FelipeRojasArr/Curiosity_SPARC/README.md

# Curiosity_SPARC
Documentación proyecto semestre i: SPARC
