FelipeRojasArr/Curiosity_SPARC/DocumentacionFinal/Análisis Mecánico SPARC Project.pdf

### Análisis Mecánico SPARC Project

Torque
De acuerdo a las especificaciones del motor a pasos NEMA 17 utilizado en el proyecto Sparc, éste proporciona un torque máximo de 3.2 Kg.cm, que de acuerdo al SI equivalen a .3138 N.m.
Al medir la tensión aplicada a la banda alrededor del eje del motor a pasos utilizando un dinamómetro didáctico, la perilla indica aproximadamente 0.4 N de tensión en ésta, el cual si lo multiplicamos por el radio de la polea alrededor del eje obtenemos el torque aplicado en éste último. En otras palabras:

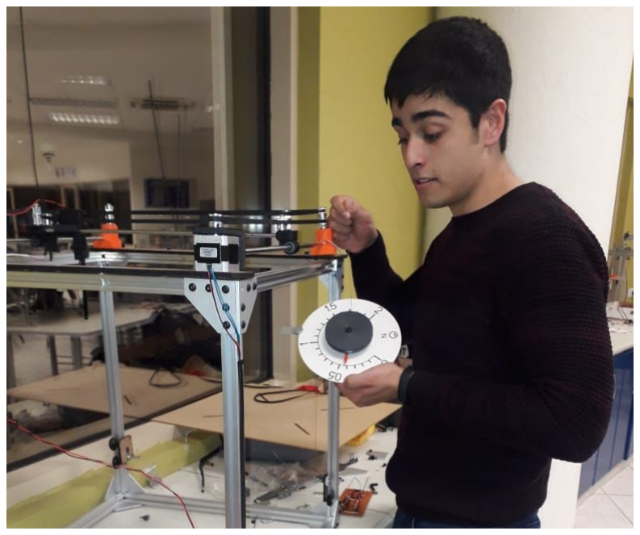
[picture p1: figure]

Imagen 1. Medición de tensión

Torque aplicado = (Fuerza)(distancia) = (0.4 N) (0. 0061 m) = .0024 N.m

La distancia se obtuvo dividiendo entre dos el diámetro externo de la polea gt2 que recibe la tensión. El torque real aplicado al sistema es entonces

.3138 N.m - .0024 N.m = .3114 N.m

Es posible inferir que el motor no se encuentra ni siquiera cerca de ser forzado o sobreexigido.

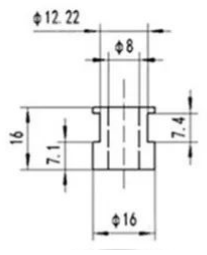
[picture p2: figure]
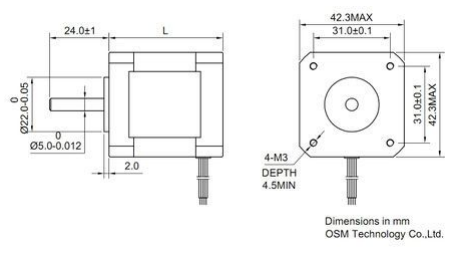
[picture p3: figure]

Imagen 2. Dimensiones de polea. | Imagen 3. Dimensiones de motor a pasos.

Factor de seguridad

La tensión de la banda calculada previamente afecta directamente al eje del motor a pasos en cuanto a Torsión y Flexión se refiere. Ambos aspectos se consideran en los teoremas de fatiga necesarios en el análisis de pruebas en diversos productos de la industria con la finalidad de aproximar la durabilidad de éstos últimos.

El siguiente análisis se basa en el teorema Mod-Goodman, que, basado serie cálculos y consideraciones que se explican con detalle a continuación, nos indica que sí el factor final n es menor a 1 nuestro sistema no es capaz de lograr 1 millón de ciclos en ejecución, mientras que siendo igual o mayor o 1 lo hace. El siguiente proceso denomina al eje del motor como fabricado en Latón.

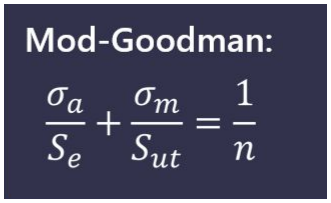
[picture p4: figure]

Imagen 4. Teorema Mod-Goodman.
Donde:

= Bending stress

= Torsion

= Endurance limit

= Ultimate tensile strength

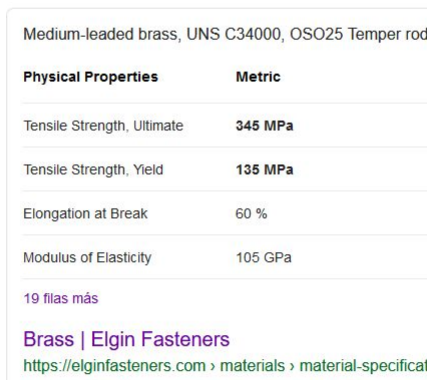
[picture p5: figure]

Imagen 5. Datos clave del latón.

El análisis parte de la obtención del Bending Stress y de la Torsion, que a su vez requieren los momentos de inercia del eje (I, J). Al ser el eje un tubo no hueco, el diámetro interno es inexistente.

Una vez con estas variables calculadas, el Bending Stress se calcula considerando los 0.4 N de fuerza aplicados casi en la punta del eje, es decir, en la parte media de la polea que se encuentra en la punta del eje. La distancia hasta el final del eje saliendo del motor son 24 mm pero el punto medio de la banda se encuentra 3.7mm debajo de eso (20.3mm ver dimensiones en imágenes). Éste momento se multiplica por c, que en este caso es el radio del eje.

Después se obtiene la Torsion, usando el torque real aplicado al eje multiplicado por el radio del mismo.

Una vez calculados los factores anteriores, sólo resta realizar la investigación correspondiente sobre el latón para obtener que Ultimate Tensile Strength = 345 MPa y que Endurance Limit = 300 GPa . Se ingresan los datos al teorema, se despeja la n y resulta que n = 27.1902. El factor es mayor a 1 con creces, el motor es capaz de rebasar un millón de ciclos trabajando.

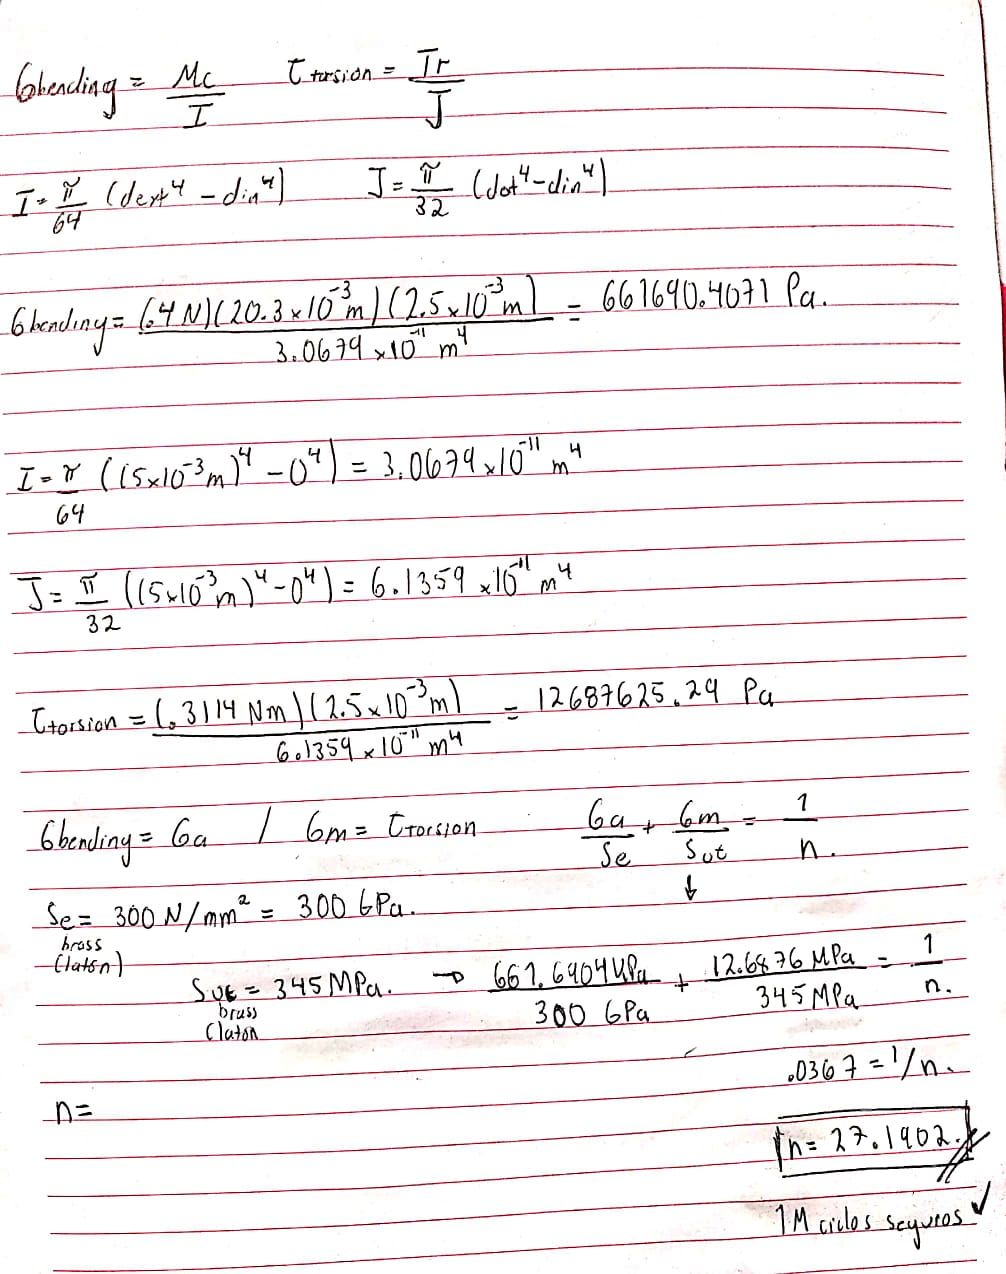
[picture p6: figure]

REFERENCIAS

Anon, | (n.d.). | [online] | Available | at:
https://www.researchgate.net/figure/Endurance-limit-on-different-materials_tbl2_256986146
Elginfasteners.com. (n.d.). Brass | Elgin Fasteners. [online] Available at:
https://elginfasteners.com/resources/materials/material-specifications/brass-material/
