FelipeRojasArr/Curiosity_SPARC/DocumentacionFinal/CodeReview Evidence.pdf

Honeywell-Resideo

Haydé Zamudio | A01363956
Angélica Luna | A01187815
Felipe Rojas | A01566041

Code Review evidence

Using GitKraken as a Git GIU, the next images shows the commits and branches the project had.

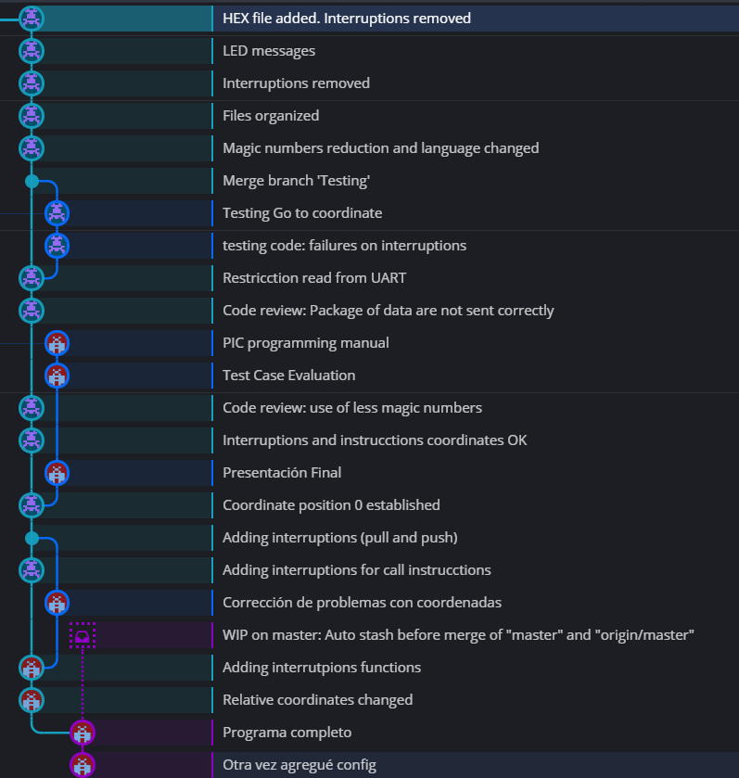
[picture p31: figure]

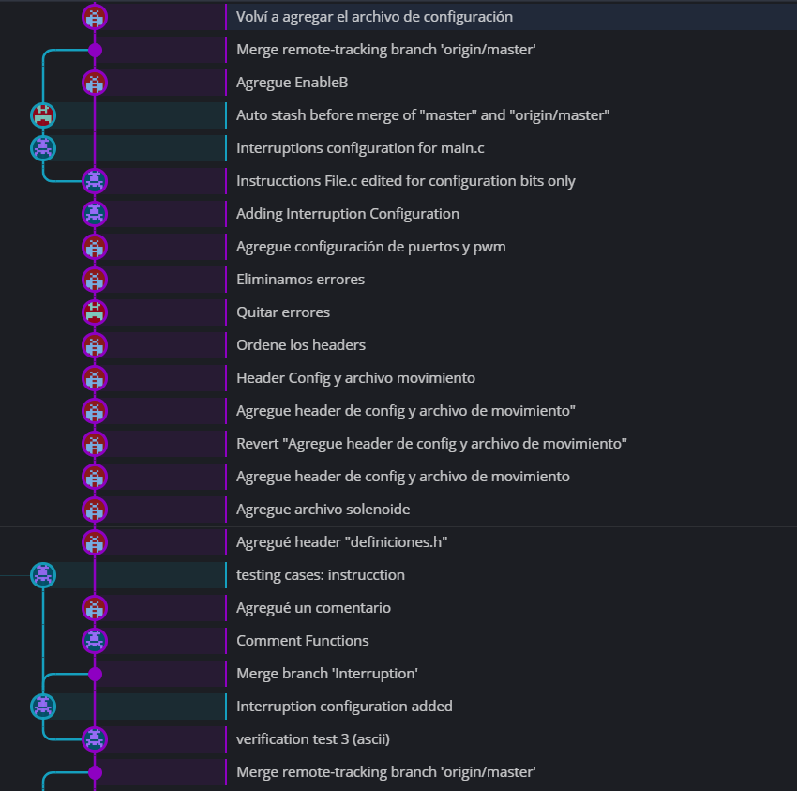
[picture p32: figure]

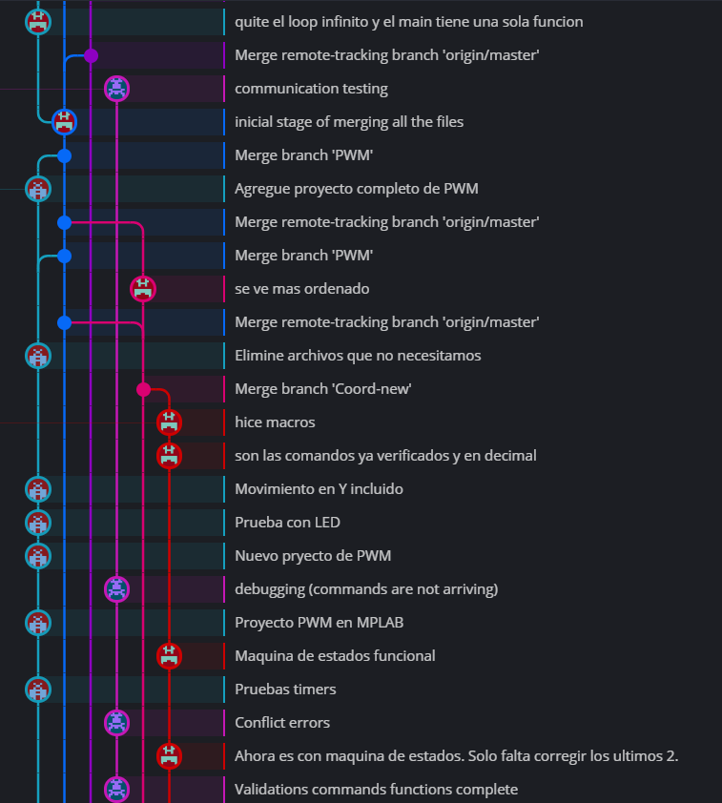
[picture p33: figure]

Code review and improvement: Code was improved not only in better algorithm but also on syntax, readability and easier to maintain. Other tools, such TortoiseSVN, helped to compare code.

Using diff with tool, it was easier to compare files. An example is this file from the project, where magic numbers were used and some conditions/instrucctions hadn’t been implemented.

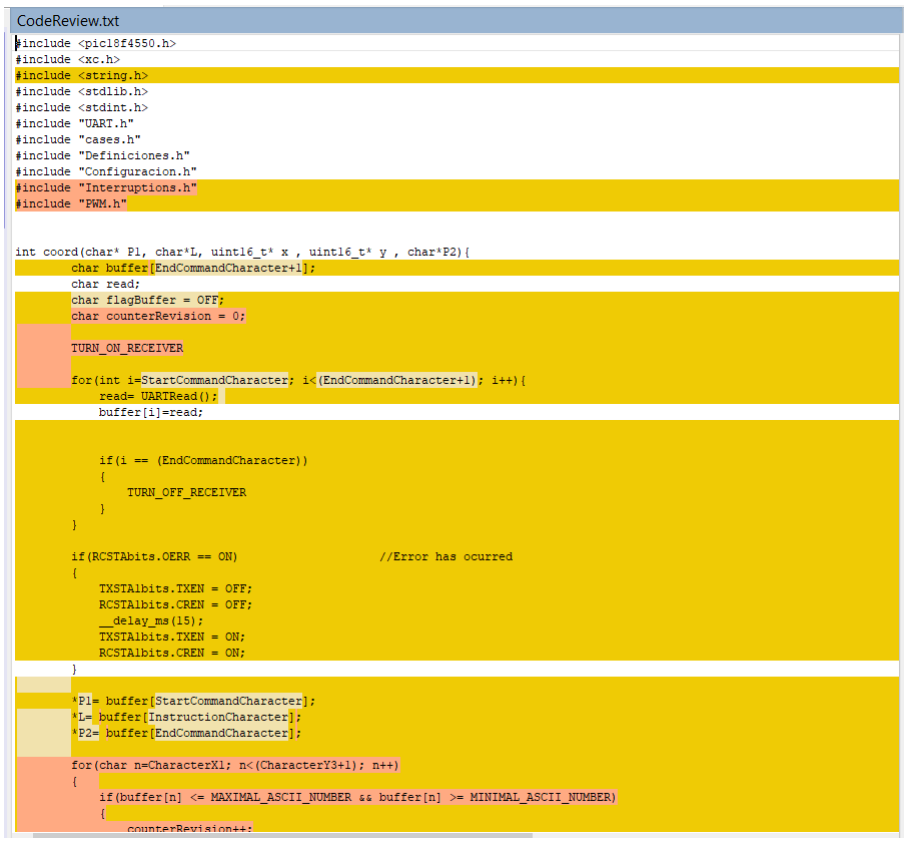
[picture p34: figure]

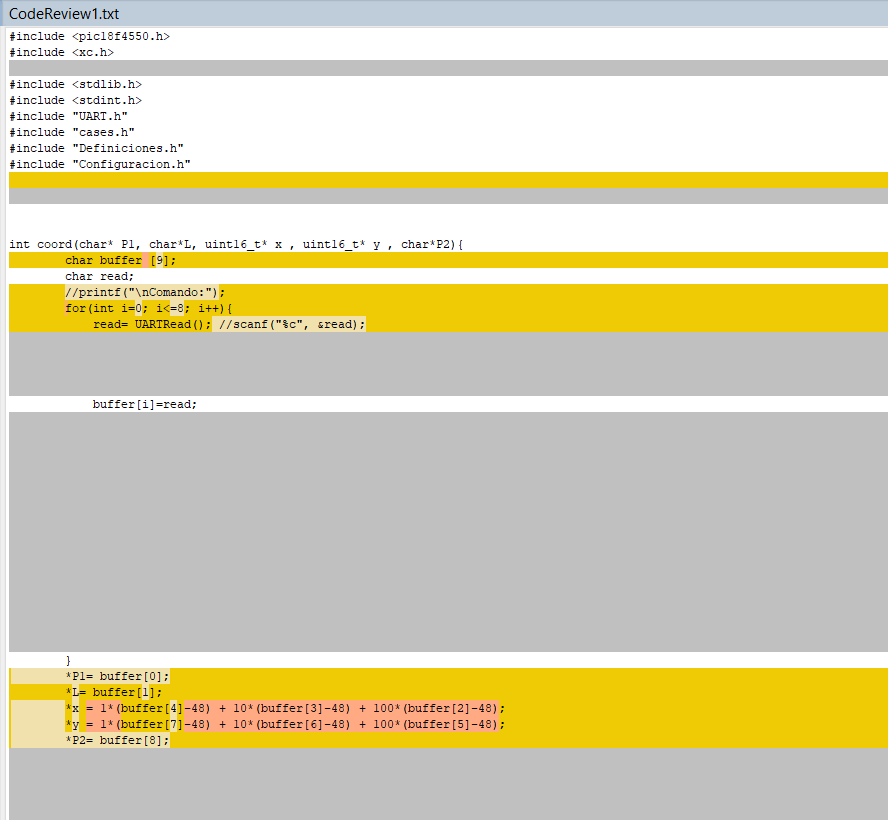
[picture p35: figure]

Also, GitKraken can compare commits

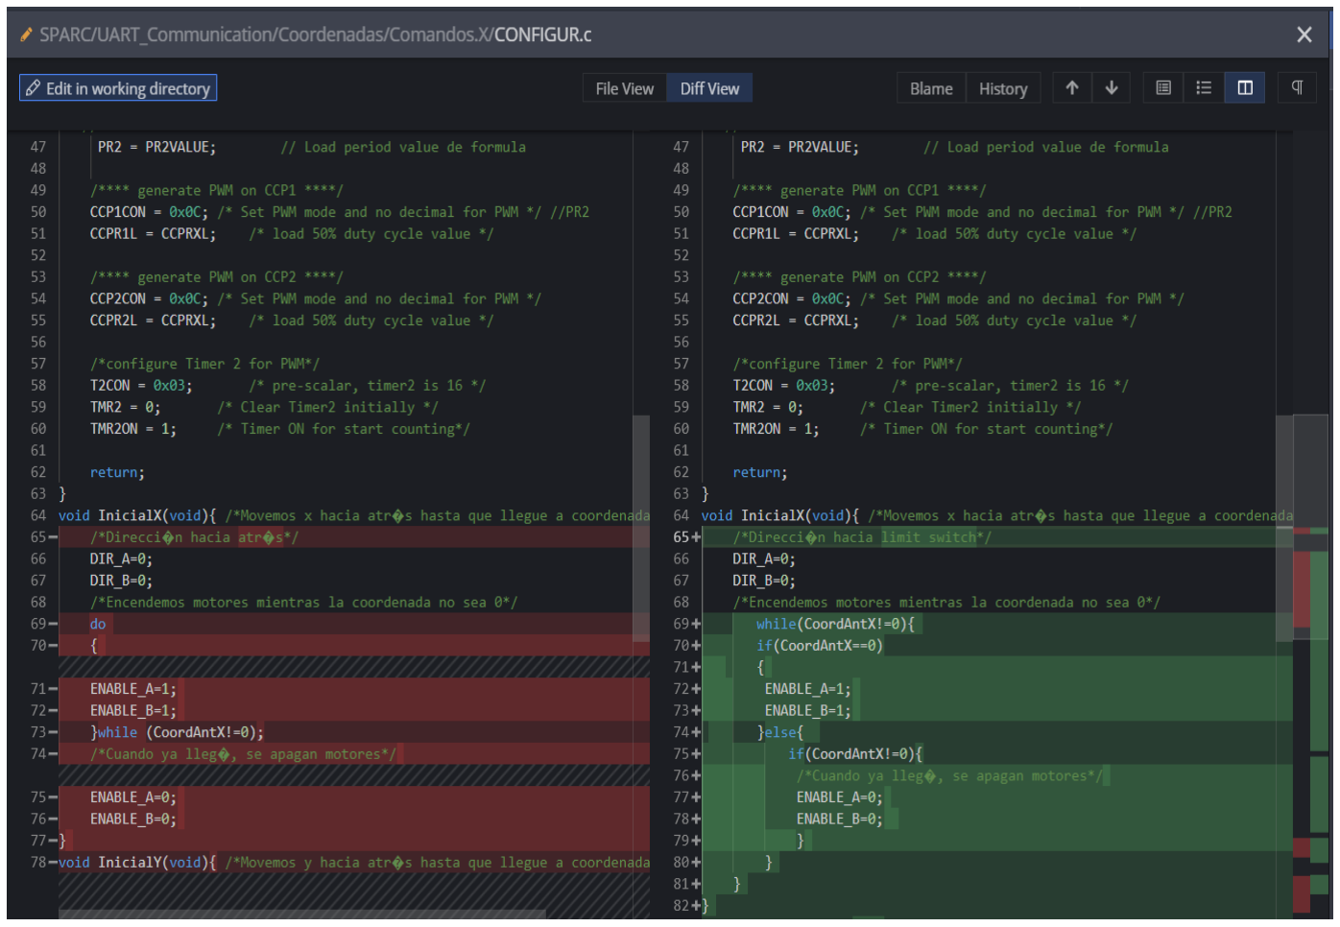
[picture p36: figure]
