FelipeRojasArr/Curiosity_SPARC/DocumentacionFinal/ActivityDiagram.png

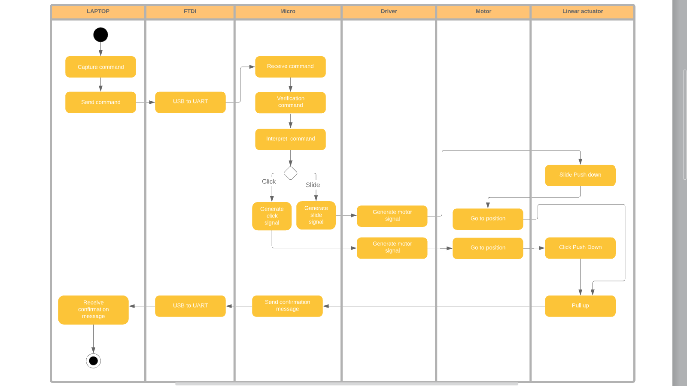
DocumentacionFinal/ActivityDiagram.png
