FelipeRojasArr/Curiosity_SPARC/DocumentacionFinal/DeploymentDiagram.png

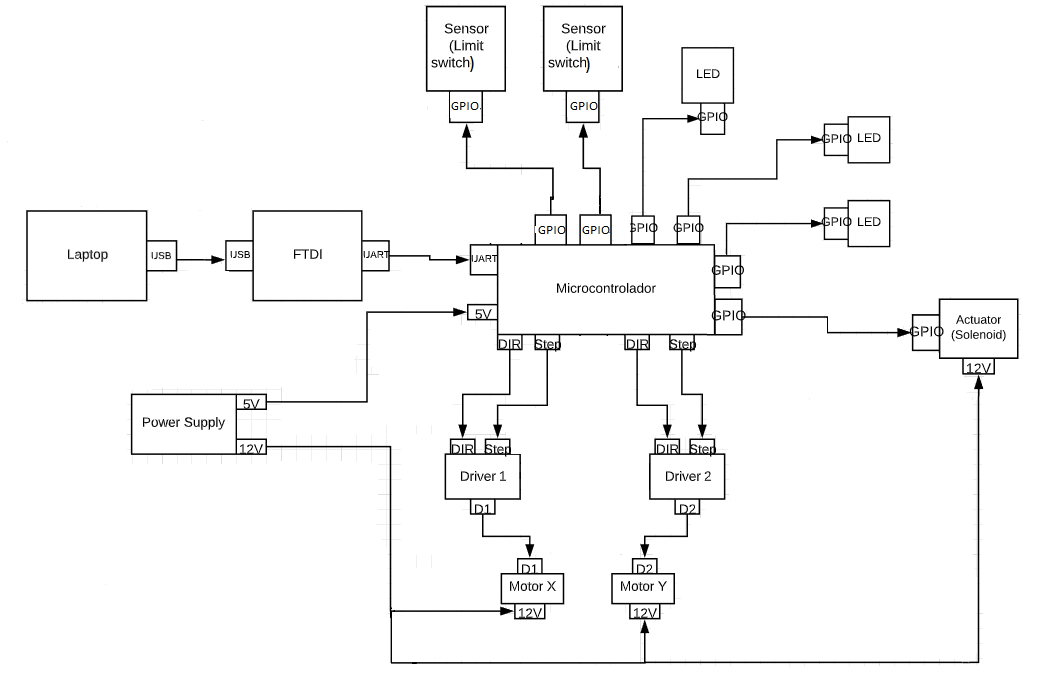
DocumentacionFinal/DeploymentDiagram.png
