FelipeRojasArr/Curiosity_SPARC/Entregables/Deployment_diagram.png

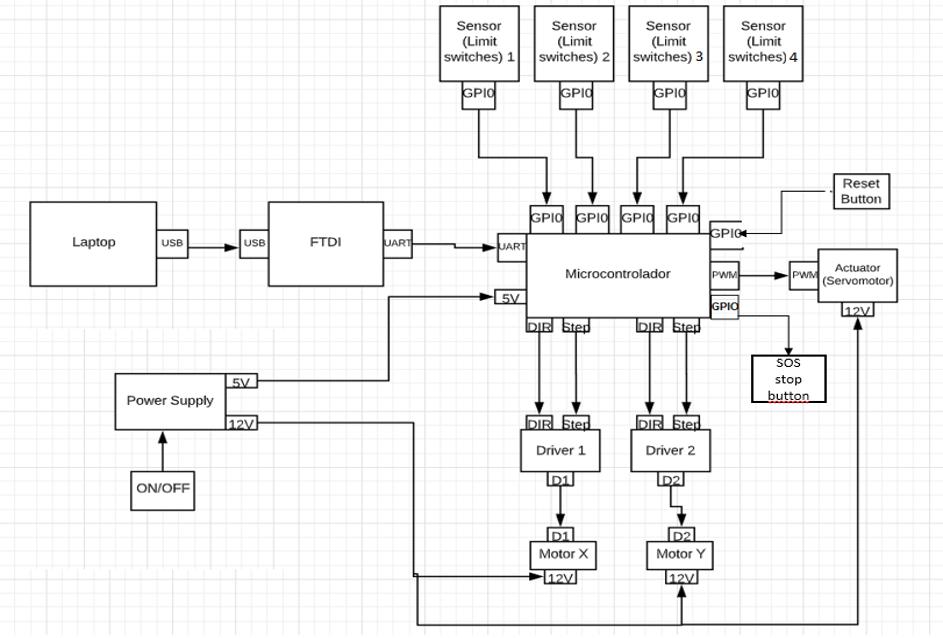
Entregables/Deployment_diagram.png
