FelipeRojasArr/Curiosity_SPARC/DocumentacionFinal/BOM COSTEADO.xlsx

Sheet: Material Ago-Dic 2019
Concepto (descripción, medidas, etc) | presentación | Cantidad | Material | Modelo/ SKU/ Código | Liga / Foto | Proveedor sugerido y/o único | comentarios | Costo Unitario | Costo Total
Perfil Estructural Aluminio 2020 (20x20 cm) | Viga de Aluminio | 6 Metros | Aluminio | HS0394 | https://sandorobotics.com/producto/hs0394/ | SanDoRobotics | 12 pedazos de 50 cm c/u | $160.00 | $1920.00
Componente Pickit 3 | Circuito empacado en plástico con cable usb. | 1 piezas | Eléctronico | PG164130 | https://articulo.mercadolibre.com.mx/MLM-577151818-pickit-3-programador-cdmx-electronica-_JM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 | CDMX ELECTRONICA: Benito juárez, Distrito Federal. |  | $452.00 | $452.00
Microcontrolador PIC18F4550 | Circuito integrado rectangular de 40 pins | 1 piezas | Electrónico | PIC18F4550-I/P | https://www.microchip.com/wwwproducts/en/PIC18F4550 | Microchip Technology Inc. 2355 West Chandler Blvd. Chandler, Arizona, USA 85224-6199 | Presentación de 40 pines de forma alargada rectangular | $87.00 | $87.00
Rueda Para Perfil Aluminio 2020 , Impresora 3d , Laser Cnc , Router Cnc | Rueda de Nylon | 16 piezas | Nylon | RB21.5x7x5 | https://articulo.mercadolibre.com.mx/MLM-647462071-rueda-para-perfil-aluminio-2020-impresora-3d-laser-cnc-router-cnc-_JM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 | PARTESCNC: Santa Catarina, Nuevo León. |  | $22.00 | $352.00
Rodamiento lm6uu. Rodamiento lineal de 6 mm de diametro | Rodamiento cilindrico de aluminio | 2 piezas | Aluminio | LM6UU | https://articulo.mercadolibre.com.mx/MLM-660595047-balero-lineal-lm6uu-6mm-rodamiento-impresora-3d-y-cnc-_JM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 | THREED: Zapopan, Jalisco. |  | $25.00 | $50.00
Rodamiento lm8uu. Rodamiento lineal de 8 mm de diametro | Rodamiento cilindrico de aluminio | 2 piezas | Aluminio | LM8UU | https://articulo.mercadolibre.com.mx/MLM-577551300-lm8uu-rodamiento-lineal-8mm-router-cnc-impresora-3d-laser-reprap-_JM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 | PARTESCNC: Santa Catarina, Nuevo León. |  | $20.00 | $40.00
Guía lineal rectificada. Diametro exterior 8mm | Varilla Lisa | 1 metro (2pzas) | Aluminio | GL8x500 | https://articulo.mercadolibre.com.mx/MLM-576147086-guia-lineal-8mm-8x500-barra-cromada-8mm-para-sc8uu-o-lm8uu-impresora-3d-router-cnc-varilla-lisa-8mm-_JM | PARTESCNC: Santa Catarina, Nuevo León. | Pedazos de mínimo 500mm | $150.00 | $300.00
Guía lineal rectificada. Diametro exterior 6mm | Varilla Lisa | 1 metro | Aluminio | Guía lineal 6mm | http://maquinariaycontrol.com.mx/tienda/barra6mm | MAQUINARIA Y CONTROLCl: Camarones 390 B, Azcapotzalco, México DF. Teléfono: 58-01-44-17 Correo electrónico: maquinariaycontrolmx@gmail.com | Pedazos de mínimo 500mm | $96.00 | $192.00
2267-POLOLU Stepper Motor:Bipolar, 200 Steps/Rev, 42×38mm, 2.8V, 1.7 A/Phase | Motor cúbico | 2 piezas | Eléctronico | 2267-POLOLU | https://www.pololu.com/product/2267 | Pololu electronics: Las Vegas, NV 89119 , (702) 262-6648 |  | $330.00 | $660.00
Polea para Banda GT2:Diametro Interior: 5mm 20 Dientes Paso 2mm Para ancho de banda 6mm | Engrane plateado dentado | 10 piezas | Aluminio/Acero | GT2 | https://articulo.mercadolibre.com.mx/MLM-584176189-3-piezas-polea-gt2-5mm-20-dientes-p-banda-6mm-impresora-3d-_JM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 | JCCHESS: Puebla, Puebla. |  | $25.00 | $250.00
Banda dentada GT2 6mm ancho | Banda dentada de poliuterano | 4 metros | Caucho | GT2 | https://articulo.mercadolibre.com.mx/MLM-673651807-metro-banda-dentada-gt2-6mm-ancho-impresora-3d-cnc-_JM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 | MARAX-ELECTRONICA: Pachuca De Soto, Hidalgo. | Banda que no sea cerrada. | $35.00 | $140.00
Led Rojo 5mm | Encapsulado | 1 piezas | Electrónico | OS-0113R | https://www.330ohms.com/products/led-rojo-claro-5mm | 330 Ohms: Cerrada Alberto Zamora 26, Col. Villa Coyoacán, (entre Alberto Zamora y Miguel Ángel de Quevedo) México, CDMX. 04000, MX Teléfono:(55) 5659-3643 / (55) 5554-6254 WhatsApp: 55 6069 0983Correo: ventas@330ohms.com |  | $4.00 | $8.00
Led Verde 5mm | Encapsulado | 1 piezas | Electrónico | P3-00031 | https://www.330ohms.com/products/kit-de-led-verde-5mm-1000-pzas | 330 Ohms: Cerrada Alberto Zamora 26, Col. Villa Coyoacán, (entre Alberto Zamora y Miguel Ángel de Quevedo) México, CDMX. 04000, MX Teléfono:(55) 5659-3643 / (55) 5554-6254 WhatsApp: 55 6069 0983Correo: ventas@330ohms.com |  | $4.00 | $8.00
Led Azul 5mm | Encapsulado | 1 piezas | Electrónico | OS-0113B | https://www.330ohms.com/products/led-azul-claro-5mm | 330 Ohms: Cerrada Alberto Zamora 26, Col. Villa Coyoacán, (entre Alberto Zamora y Miguel Ángel de Quevedo) México, CDMX. 04000, MX Teléfono:(55) 5659-3643 / (55) 5554-6254 WhatsApp: 55 6069 0983Correo: ventas@330ohms.com |  | $4.00 | $8.00
Power Supply Fuente De Poder Conmutada Voltaje 12v 10a 120w | Caja de aluminio | 1 pieza | Electrónico | S-120-12 | https://articulo.mercadolibre.com.mx/MLM-583064082-power-supply-fuente-de-poder-conmutada-voltaje-12v-10a-120w-_JM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 | INGENIERIA M_M: Gustavo A. Madero, Distrito Federal. |  | $350.00 | $350.00
to the end of the images gallery Switch de balancín, de 1 polo, 1 tiro, 2 posiciones (ON-OFF), con piloto, 125/250 Vca | Switch encapsulado | 1 pieza | Plastico | BTS-19 | https://www.steren.com.mx/switch-de-balancin-de-1-polo-1-tiro-2-posiciones-on-off-con-piloto-125-250-vca.html | Electrónica Steren S.A. de C.V | 3 pines, color negro | $15.00 | $30.00
Botón Paro De Emergencia -16mm Tipo Hongo Plastico. Rojo | Botón tipo hongo | 1 pieza | Plastico | XB6-SP542 | https://www.inyepartes.com/producto/paro-de-emergencia-16mm-hongo-plastico-1p/ | INYEPARTES: Guadalajara, Jalisco. |  | $45.00 | $45.00
Cable USB- TTL Part No: TTL-232R-5V-AJ | Cable con recubrimiento de pláctico | 1 pieza | Electrónico | TTL-232R-5V-AJ | https://mexico.newark.com/ftdi/ttl-232r-5v-aj/cable-ttl-to-usb-serial-converter/dp/33R1437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 | Newark: 01.800.463.9275 | TTL-232R-5V-AJ - Cable, USB a TTL, Convertidor Serial, Jack de Audio, 1.8m | $520.45 | $520.45
Escuadra Tipo L-90 Grados Para Perfil Eje De Aluminio 2020 | Escuadra en forma de L | 4 piezas | Aluminio | EscuadraInt | https://articulo.mercadolibre.com.mx/MLM-663181795-escuadra-interna-tipo-l-para-perfil-estructural-20x20mm-2020-_JM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 | THREED: Zapopan, Jalisco. |  | $35.00 | $140.00
Placa Escuadra Aluminio Para Perfil 2020 | Placa con 5 orificios | 24 piezas | Aluminio | P452020 | https://articulo.mercadolibre.com.mx/MLM-607886086-placa-escuadra-aluminio-para-perfil-2020-_JM?quantity=1 | PARTESCNC: Santa Catarina, Nuevo León. |  | $70.00 | $1680.00
Driver A4988 con disipador de calor | Componente tipo cucarachita 16 patas | 2 piezas | Electrónico | A4988 | https://articulo.mercadolibre.com.mx/MLM-643411500-driver-a4988-con-disipador-para-motores-_JM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 | SPORTSGOODSMX |  | $25.00 | $75.00
Tuerca T M5 Para Perfil De Aluminio 2020 | Tuerca alargada | 120 piezas | Aluminio | TT2020 | https://articulo.mercadolibre.com.mx/MLM-607880282-tuerca-t-m5-para-perfil-de-aluminio-2020-_JM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 | PARTESCNC: Santa Catarina, Nuevo León. |  | $2.89 | $346.80
Tuerca T M4 Para Perfil De Aluminio 2020 | Tuerca alargada | 50 piezas | Aluminio | TT-OB20X4MM | https://www.didacticaselectronicas.com/index.php/cnc-e-impresoras-3d/tuercas-y-tornillos/tuerca-t,-m4,-6x10mm,-para-perfil-ob2020-tt-ob20x4mm-detail | I+D electronica |  | $3.92 | $196.00
Cjmcu-trrs 3.5 Mm | Componente con planilla electrica | 2 piezas | Electrónico | CJMCU-TRRS | https://electrocrea.com/products/conector-de-audio-3-5mm-cjmcu-trrs | Electrocrea: (868) 154 89 26 / contacto@electrocrea.com |  | $35.00 | $35.00
Cerradura Eléctrica 12v Chapa Puerta Solenoide Arduino | Caja de aluminio | 1 pieza | Electrónico |  | https://articulo.mercadolibre.com.mx/MLM-640791582-cerradura-electrica-12v-chapa-puerta-solenoide-arduino-_JM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 | TECNEU_GDL: El Salto, Jalisco. |  | $139.00 | $139.00
Heschen Solenoid Electromagnet JF-0837 DC 12V 200g | Caja rectangular de aluminio con actuadro de fuera | 1 pieza | Electrónico | JF-0837 | https://www.heschen.com/product-page/heschen-solenoid-electromagnet-jf-0837-dc-12v-200g-actuador-lineal-de-empuje | Heschen: Tel. 86-13968871152 E-mail: heschen@outlook.com |  | $208.14 | $208.14

Sheet: Ejemplo
NOMBRE DEL SOLICITANTE: | Ana Apodaca |  |  | fecha: | 7 de septiembre 2018
JUSTIFICACIÓN: | Material para semestre i
Equipo | Concepto (descripción, medidas, etc) | presentación | Cantidad | Material | Marca | Modelo/ SKU/ Código | Liga / Foto | Proveedor sugerido y/o único | Fecha Actividad /Utilización Material | comentarios
Transcedental | Adafruit Accessories Encased I2C Temp Humidity Sensor | Caja | 1 | Sensor de Humedad | Adafruit | 1293 | https://www.mouser.mx/ProductDetail/Adafruit/1293 | Mouser | 2018-11-05
Transcedental | Adafruit Accessories Mesh-protected Weather-proof Temperature/Humidity Sensor - SHT10 | Caja | 1 | Sensor temperatura y humedad | Adafruit | 1298 | https://www.mouser.mx/ProductDetail/Adafruit/1298 | Mouser | 2018-11-05
Temperance | SMAKN® AM2303 Measuring Range -40-125C Digital Humidity Temperature Sensor | Unidad | 2 | Sensor de humedad y temperatura | SMAKN | 709127307107 | https://www.amazon.com/Measuring-40-125C-Digital-Humidity-Temperature/dp/B00R4LB7QO | Amazon | 2018-11-05 | AMAZON USA
Transcedental | 100 Leds Ultrabrillantes De 5mm colores Variados | Caja | 1 | Led Ultrabillantes | - | - | https://articulo.mercadolibre.com.mx/MLM-554922069-100-leds-ultrabrillantes-de-5mmcolores-variados-_JM | Mercadolibre | 2018-11-05
Justice, Courage, Temperance, Wisdom, Humanity, Transcedental | Memoria Micro SD SanDisk 16 GB con Adaptador SD | Caja | 6 | Memoria de almacenamiento | SanDisk | -- | https://www.walmart.com.mx/Fotografia/Memorias-Baterias-y-Cargadores/Memorias-Micro-SD/Memoria-Micro-SD-SanDisk-16-GB-con-Adaptador-SD_00061965906688 | Wallmart
Humanity | SENSOR HUMID/TEMP 5V I2C 2% MOD | Granel con sonda | 1 | Sensor | Adafruit Industries LLC | 1528-1311-ND | https://www.digikey.com.mx/product-detail/es/adafruit-industries-llc/1293/1528-1311-ND/5356796 | Digi-Key
Humanity | SHT31-D - Humidity, Temperature Sensor Evaluation Board | Paquete con 1 placa | 1 | Placa de evaluación | Adafruit Industries LLC | 1528-1540-ND | https://www.digikey.com.mx/product-detail/es/adafruit-industries-llc/2857/1528-1540-ND/5804106 | Digi-Key
Temperance, Wisdom | Board Mount Humidity Sensors Humid & Temp Sensor | Caja | 3 | sensor de humedad | Sensirion | 403-SHT21S | https://www.mouser.com/ProductDetail/Sensirion/SHT21S | Mouser Electronics | 2018-11-05
Courage, Temperance | Sensor de humedad SHT31-ARP-B | Tipo bolsa | 3 | Sensor de humedad | Sensirion | 403-SHT31-ARP-B | https://www.mouser.mx/ProductDetail/Sensirion/SHT31-ARP-B | Mouser | 2018-11-05
Justice, Wisdom | Board Mount Humidity Sensors Humid & Temp Sensor | Caja | 3 | Sensor de Humedad | Sensirion | 403-SHT71 | https://www.mouser.mx/ProductDetail/Sensirion/SHT71 | Mouser Electronics
Courage | kwmobile Matriz LED 8 x 32 - Módulo de Matriz para Raspberry Pi y Arduino - Pantalla LED Arduino y Raspberry Pi | Caja | 3 | Matriz de Leds | Kwmobile | 40812_m000523 | https://www.amazon.com.mx/kwmobile-Matriz-LED-32-Raspberry/dp/B06XJ9ZX17 | Amazon | 2018-11-05
Humanity | Batería recargable BATTERY LEAD ACID 6V 1.2AH | Paquete con 1 unidad | 1 | Batería recargable | B B Battery | 522-1000-ND | https://www.digikey.com.mx/product-detail/es/b-b-battery/BP1.2-6-T1/522-1000-ND/653321 | Digi-Key
Justice, Curage, Wisdom | NTC Thermistors 1K OHM 20% BEAD | Caja | 3 | Sensor Temperatura | Amphenol Advanced Sensors | 527-P60BA102M | https://www.mouser.mx/ProductDetail/Amphenol-Advanced-Sensors/P60BA102M | Mouser Electronics
Justice, Temperance | NTC Thermistors 100K 1% 4190K 38MM AWG24 | Caja | 3 | Sensor Temperatura | Vishay / BC Components | 594-NTCALUG01A104F | https://www.mouser.mx/ProductDetail/Vishay-BC-Components/NTCALUG01A104F | Mouser Electronics
Courage | Sensor de humedad HIH8121 | Tpo bolsa | 1 | Sensor de humedad | Honeywell | 785-HIH8121-021-001 | https://www.mouser.mx/ProductDetail/Honeywell/HIH8121-021-001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 | Mouser | 2018-11-05
Temperance | Temperature Sensor Modules GAS MEASURE SENSOR HTM1735LF | Unidad | 1 | sensor de temp y humedad | Measurments specialities | 824-HPP805D033 | https://www.mouser.com/ProductDetail/Measurement-Specialties/HPP805D033?qs=sGAEpiMZZMsywdCd57IrWeTG7axTDJOK | Mouser Electronics | 2018-11-05 | NOHAY EN STOCK
Humanity | Temperature Sensor Development Tools THERMOCOUPLER UEXT MODULE | Paquete con 1 unidad | 1 | Placa de evaluación | Olimex Ltd. | 909-MOD-TC | https://www.mouser.mx/ProductDetail/Olimex-Ltd/MOD-TC?qs=sGAEpiMZZMsSqJ2n7yWjAjX9mvrHOjQi | Mouser
Temperance | Termistores de coeficiente de temperatura negativo (NTC) 10ohms 2amps Clinch lead | Unidad | 2 | Sensor de temperatura | Semitec | 954-10D2-08LC | https://www.mouser.com/ProductDetail/Semitec/10D2-08LC | Mouser Electronics | 2018-11-05
Justice | NTC Thermistors 10 Kohm NTC THERMISTOR PROBE | Caja | 1 | Sensor Temperatura | Ametherm | 995-PANR103395-342 | https://www.mouser.mx/ProductDetail/Ametherm/PANR-103395-342 | Mouser Electronics
Wisdom | Batería de litio 5V salidas 1A y 2.1A | Caja con 1 unidad | 1 | Batería recargable | ADATA | APT100-10000M-5V-CBLWH | https://www.amazon.com.mx/ADATA-APT100-Bater%C3%ADa-10000-blanco/dp/B06XCSNBZY?th=1 | Amazon | 2018-11-05
Temperance | DZYDZR 3pcs 2.1mm x 5.5mm Cable Alimentacion DC 12V Cable Divisor 1 Hembra a 2 Macho Negro para LED, CCTV, Coche, Monitores (30cm) | Caja con tres unidades | 1 | Cable divisor de corriente hembra a macho de 2.1mm | Eleidgs | B01N05C85K | https://www.amazon.com.mx/DZYDZR-Alimentacion-Divisor-Hembra-Monitores/dp/B01N05C85K | Amazon | 2018-11-05
Transcedental | Bgd35cir Buzzer De 3,5 Khz, De 3 A 24 Vcc, Con Tono De Pulso | Bolsa | 1 | Buzzer de 3.5 Khz | - | Bgd35cir | https://articulo.mercadolibre.com.mx/MLM-598945339-bgd35cir-buzzer-de-35-khz-de-3-a-24-vcc-con-tono-de-pulso-_JM | Mercadolibre | 2018-11-05
Transcedental, Courage | BNTECHGO 10/12/14/16/18 - Alambre de silicona de calibre 600 V 30 pies (negro y rojo de 3 pies: 10 AWG, 14 AWG, 12 AWG, 16 AWG y 18 AWG), flexible resistente a altas temperaturas, hilos de alambre eléctrico de cobre estañado | Caja | 2 | Alambre de Silicona Calibre 14 | BNTECHGO | BNTECHGO?10/12/14/16/18 | https://www.amazon.com.mx/BNTECHGO-10-resistente-temperaturas-el%C3%A9ctrico/dp/B01NBE9C91 | Amazon | 2018-11-05
TODOS | TECLADO MATRICIAL ALFANUMÉRICO RÍGIDO 4X4 | Caja | 6 | Teclado matricial | OEM | CWTM4040-B7-NS14-0 | https://hetpro-store.com/teclado-matricial-alfanumerico-rigido-4x4/ | Hetpro |  | Otros Proveedores: AMAZON, MERCADO LIBRE, MICROBOT, ELECTROCREA
Humanity | THERMISTOR NTC 10KOHM 3976K BEAD | Paquete con 1 unidad | 1 | Sensor | TE CONNECTIVITY SENSORS | GA10K3MCD1 | https://www.digikey.com.mx/product-detail/es/te-connectivity-measurement-specialties/GA10K3MCD1/223-1544-ND/5277239 | Digi-Key
Transcedental | Módulo de Bluethooth (HC-06) | Bolsa | 1 | Módulo Bluetooth | - | HC-06 | https://electrocrea.com/products/modulo-bluetooth-hc-06 | Electrocrea | 2018-11-05
Transcedental | Industrial Temperature Sensors 100Ohm, 28 Gauge .1%Linearity,Ceramic | Caja | 0 | Sensor de temperatura | Honeywell | HEL-711-1-12-00 | https://www.mouser.mx/ProductDetail/Honeywell/HEL-711-T-1-12-00 | Mouser | 2018-11-05 | NOHAY EN STOCK
Wisdom, Transcedental | Industrial Temperature Sensors THERMISTORS | Caja con 1 unidad | 2 | Termistor | Honeywell | HEL-711-U-0-12-00 | https://www.mouser.mx/ProductDetail/Honeywell/HEL-711-U-0-12-00 | Mouser Electronics MX | 2018-11-05
Transcedental | Punta Zonda Termopar Tipo K -100c 1250c 1m Para Termometro | Bolsa | 1 | Termopar Tipo K | - | K | https://articulo.mercadolibre.com.mx/MLM-572537404-punta-zonda-termopar-tipo-k-100c-1250c-1m-para-termometro-_JM | Mercadolibre | 2018-11-05
Transcedental, Humanity, Wisdom | StarTech MXT1003MBK Cable de Extension DB-9, Macho/Hembra, color Negro | Bolsa | 3 | Cable serial Hembra-Macho | Startech | MXT1003MBK | https://www.amazon.com.mx/StarTech-MXT100-Conexi%C3%B3n-Directa-Hembra/dp/B00A6GIV9K | Amazon | 2018-11-05
Transcedental | Bateria Portatil Recargable Power Bank 12500 Mah 2 Usb Pila | Caja | 1 | Power Bank | ADATA | P12500D | https://articulo.mercadolibre.com.mx/MLM-630848729-bateria-portatil-recargable-power-bank-12500-mah-2-usb-pila-_JM | Mercadolibre | 2018-11-05
Transcedental | Phone Connectors audio jack 3.5 mm SJ-43515TS-SMT-TR (4 Position) | Bolsa | 4 | Conector Audio Jack | CUI INC | SJ-43515TS-SMT-TR | https://www.mouser.mx/ProductDetail/CUI/SJ-43515TS-SMT-TR | Mouser | 2018-11-05
Transcedental | Phone Connectors audio plug 3.5mm 4conductor Cable mnt | Bolsa | 4 | Conector 3.5mm | CUI INC | SP-3540 | https://www.mouser.mx/ProductDetail/CUI/SP-3540 | Mouser | 2018-11-05
Courage | Datalogic Battery Pack, QuickScan Mobile QM2100 - Batería/Pila recargable | Caja | 1 | Bateria recargable | Datalogic | V381213 | https://www.amazon.com.mx/Datalogic-Battery-QuickScan-Mobile-QM2100/dp/B0043YDOIE | Amazon | 2018-11-05
Humanity | Z2-K-2M (IEC) - Thermocouple, PTFE, Exposed Welded Tip, Disc, K, -75 C, +250 C, 2 m | Paquete con 1 unidad | 1 | Sensor | LABFACILITY | Z2-K-2M | https://mexico.newark.com/labfacility/z2-k-2m-iec/thermocouple-ptfe-exposed-welded/dp/68C2611?st=termopar | Newark |  | En UK???
Transcedental, Courage | Busboard ZW-MM-20 Colored Jumper Wire, ZipWire, 40 Piece, Male to Male, 7.87" Length | Caja | 2 | Jumper Macho-Macho | BusBoard | ZW-MM-20 | https://www.amazon.com.mx/Busboard-ZW-MM-20-Colored-Jumper-ZipWire/dp/B0131VFPZY | Amazon | 2018-11-05
TODOS | Adaptador de corriente cargador de alimentación fuente de alimentación 5V 2A | Caja con 1 unidad | 6 | Adaptador de corriente | easyday |  | https://www.amazon.com.mx/Alimentaci%C3%B3n-alimentaci%C3%B3n-5V-2A-Inal%C3%A1mbrico/dp/B07C967P43?amp&amp&amp | Amazon | 2018-11-05
 |  |  | 76
