FelipeRojasArr/Curiosity_SPARC/(list of files, cad)

Other CAD files:
2D drawings/61205K790_FIXED ALIGNMENT LINEAR BALL BRNG.SLDDRW
2D drawings/6661K110_BALL BEARING.SLDDRW
2D drawings/Lateral1.SLDDRW
2D drawings/LeadScrew Nut 8mm x 2mmPitch.SLDDRW
2D drawings/Superior.SLDDRW
2D drawings/carrito eje x.SLDDRW
2D drawings/carrito eje y para tuerca2.SLDDRW
2D drawings/soporte frontal.SLDDRW
2D drawings/torre para motor.SLDDRW
2D drawings/varilla 10 mm 2.SLDDRW
2D drawings/varilla eje y.SLDDRW
