FelipeRojasArr/Curiosity_SPARC/DocumentacionFinal/Test_Case_Evaluation.xlsx

Sheet: TestCase1_Loop1
Test case ID: | EVA-TSCS-001.
Test case Name: | First Evaluation related with Firmware on SPARC.
Goal: | Verify and validate that the requirements related to Serial communication and Control on SPARC firmware are correct according to Product Specifications and Requirements.
Steps:
# | Action | Expected Result | Given Notes | Result
1 | Turn-On and -Off the unit three times | The unit can support power lost without problems | Wait at least 10 seconds between reboots | The unit can support power lost without problems. It restarts position every time it starts.
7 | Send a valid command | Device Under Test (DUT) executes the specified command | If team requiments specify an acknowledge from commands, verify in terminal that they are sent. | Device Under Test (DUT) moves to the corresponding point. There's no visual acknowledge.
8 | Repeat step 6 | DUT should clear buffer of inputs/outputs (E.g. should not repeat the previous command) |  | Sends error message and asks for a new valid one.
9 | Send the SPARC a command to execute a Touch/Press screen. | DUT able to do Touch/Press screen. |  | SPARC generates a touch.
10 | Send command to execute movement on X | DUT able to move on X | Reviewer: Take the velocity of movement and compare with the Teams requirement If team requiments specify an acknowledge from commands, verify in terminal that they are sent. | DUT able to move on X
11 | Send command to execute movement on Y | DUT able to move on Y | Reviewer: Take the velocity of movement and compare with the Teams requirement If team requiments specify an acknowledge from commands, verify in terminal that they are sent. | DUT able to move on Y
12 | Execute multiple movements on Y that go beyond the limits of the work area. | DUT able to detect limit on Y and stop operation. |  | The SPARC does not accept commads that go beyond the work area. It sends error message and ask for a new command.
13 | Execute multiple movements on X that go beyond the limits of the work area. | DUT able to detect limit on X and stop operation. |  | The SPARC does not accept commads that go beyond the work area. It sends error message and ask for a new command.
14 | Execute a Slide screen command. | DUT able to execute Slide movements | Reviewer: Verify if team under revision has the Slide Screen Command requirement defined. If team requiments specify an acknowledge from commands, verify in terminal that they are sent. | SPARC does a slide movement.
# | Action | Expected Result | Notes | Result
Inputs:
Pre-Conditions: | Docklight is used as a serial terminal that allows the tester to freely select any baud rate, stop bits, payload, bit parity and configurations.
Post-Conditions:
Date Created: | 2019-11-08
Date Executed: | 2019-12-04
Tags:
Comments: | Basic behavior of the SPARC works well. Only serial behavior was tested.

Sheet: TestCase1_Loop2
Test case ID: | EVA-TSCS-001.
Test case Name: | First Evaluation related with Firmware on SPARC.
Goal: | Verify and validate that the requirements related to Serial communication and Control on SPARC firmware are correct according to Product Specifications and Requirements.
Steps:
# | Action | Expected Result | Given Notes | Result
1 | Turn-On and -Off the unit three times | The unit can support power lost without problems | Wait at least 10 seconds between reboots | The unit can support power lost without problems. It restarts position every time it starts.
2 | Open Serial Terminal at and set it to 110 baud rate. Send Init Command | Device Under test must not reset or break serial communication | The Designer should specify baudrate and be prepared to withstand errors and maintain a robust control when communication protocol is not started. If no baudrate is specified in the manual, then it should be assumed the SPARC will work with any baud rate. | It receive trash while having the wrong baud rate. It recovers its normal behavior when ideal baud rate is specified.
3 | Open Serial terminal at 921600 baudrate. Send Init Command | Device Under test must not reset or break serial communication | The developer must specify baudrate and prepare the SPARC firmware to robust error control when communication protocol is not started. If not baudrate then should be work with any velocity | Tx sends but Rx doesn't receives. It recovers its normal behavior when ideal baud rate is specified.
4 | Similar to steps 2 and 3, repeat with some specific field related to UART protocol like different stop bits, parity and data bits in the payload. | Device Under test must not reset or break serial communication | The designer should specify the configuration for their protocol and develop SPARC firmware to be prepared to control exceptions. | Data bit 5-No comunication. Wrong parameter. 6-No comunication. Wrong parameter. 7-If it's suddenly changed , it starts to send trash. 8-Ideal data bit. Stop bit 1- Works well 1.5- Breaks comunicación 2- Works well Parity bit None-Ideal Even- Sends trash. Odd-Sends trash. Space- Sends trash. Mark- Sends trash.
5 | Configure the Serial Terminal with the comunication parameters defined by developer. Send a batch of multiple commands without delays. | Device Under Test must be able to detect invalid commands and not crash. |  | Only one command is accepted at a time. It does not accept new commands while executing movement.
6 | On Serial Terminal send the command specified by the SPARC protocol to prepare the DUT to receive commands but send an invalid command. | Device Under Test able to detect void/invalid commands |  | Sends error message and asks for a new valid one. Corresponding led does not turns on.
7 | Send a valid command | Device Under Test (DUT) executes the specified command | If team requiments specify an acknowledge from commands, verify in terminal that they are sent. | Device Under Test (DUT) executes the specified command. There's visual no acknowledge(LED).
8 | Repeat step 6 | DUT should clear buffer of inputs/outputs (E.g. should not repeat the previous command) |  | Sends error message and asks for a nee valid one.There's visual no acknowledge(LED).
9 | Send the SPARC a command to execute a Touch/Press screen. | DUT able to do Touch/Press screen. |  | SPARC generates a touch perfectly.
10 | Send command to execute movement on X | DUT able to move on X | Reviewer: Take the velocity of movement and compare with the Teams requirement If team requiments specify an acknowledge from commands, verify in terminal that they are sent. | DUT able to move on X
11 | Send command to execute movement on Y | DUT able to move on Y | Reviewer: Take the velocity of movement and compare with the Teams requirement If team requiments specify an acknowledge from commands, verify in terminal that they are sent. | DUT able to move on Y
12 | Execute multiple movements on Y that go beyond the limits of the work area. | DUT able to detect limit on Y and stop operation. |  | The SPARC does not accept commads that go beyond the work area. It sends error message and ask for a new command.There's visual no acknowledge(LED).
13 | Execute multiple movements on X that go beyond the limits of the work area. | DUT able to detect limit on X and stop operation. |  | The SPARC does not accept commads that go beyond the work area. It sends error message and ask for a new command.There's visual no acknowledge(LED).
14 | Execute a Slide screen command. | DUT able to execute Slide movements | Reviewer: Verify if team under revision has the Slide Screen Command requirement defined. If team requiments specify an acknowledge from commands, verify in terminal that they are sent. | The actuator got stuck at the end of the slide.
# | Action | Expected Result | Notes | Result
Inputs:
Pre-Conditions: | Docklight is used as a serial terminal that allows the tester to freely select any baud rate, stop bits, payload, bit parity and configurations.
Post-Conditions:
Date Created: | 2019-12-08
Date Executed: | 2019-12-10
Tags:
Comments: | Complete test, hardware and software. The problems at setting the initial position of the actuator to begging program last. The actuator got stuck when making a slide. Leds are no configurated. Positioning works well.

Sheet: TestCase1_Loop3
Test case ID: | EVA-TSCS-001.
Test case Name: | First Evaluation related with Firmware on SPARC.
Goal: | Verify and validate that the requirements related to Serial communication and Control on SPARC firmware are correct according to Product Specifications and Requirements.
Steps:
# | Action | Expected Result | Given Notes | Result
1 | Turn-On and -Off the unit three times | The unit can support power lost without problems | Wait at least 10 seconds between reboots | The unit can support power lost without problems. It restarts position every time it starts. Blue LED turns on when the SPARC turns on.
2 | Open Serial Terminal at and set it to 110 baud rate. Send Init Command | Device Under test must not reset or break serial communication | The Designer should specify baudrate and be prepared to withstand errors and maintain a robust control when communication protocol is not started. If no baudrate is specified in the manual, then it should be assumed the SPARC will work with any baud rate. | It receive trash while having the wrong baud rate. It recovers its normal behavior when ideal baud rate is specified.
3 | Open Serial terminal at 921600 baudrate. Send Init Command | Device Under test must not reset or break serial communication | The developer must specify baudrate and prepare the SPARC firmware to robust error control when communication protocol is not started. If not baudrate then should be work with any velocity | Tx sends but Rx doesn't receives. It recovers its normal behavior when ideal baud rate is specified.
4 | Similar to steps 2 and 3, repeat with some specific field related to UART protocol like different stop bits, parity and data bits in the payload. | Device Under test must not reset or break serial communication | The designer should specify the configuration for their protocol and develop SPARC firmware to be prepared to control exceptions. | Data bit 5-No comunication. Wrong parameter. 6-No comunication. Wrong parameter. 7-If it's suddenly changed , it starts to send trash. 8-Ideal data bit. Stop bit 1- Works well 1.5- Breaks comunicación 2- Works well Parity bit None-Ideal Even- Sends trash. Odd-Sends trash. Space- Sends trash. Mark- Sends trash.
5 | Configure the Serial Terminal with the comunication parameters defined by developer. Send a batch of multiple commands without delays. | Device Under Test must be able to detect invalid commands and not crash. |  | Only one command is accepted at a time. It does not accept new commands while executing movement.
6 | On Serial Terminal send the command specified by the SPARC protocol to prepare the DUT to receive commands but send an invalid command. | Device Under Test able to detect void/invalid commands |  | Sends error message and asks for a new valid one. Corresponding led does not turns on.
7 | Send a valid command | Device Under Test (DUT) executes the specified command | If team requiments specify an acknowledge from commands, verify in terminal that they are sent. | Device Under Test (DUT) executes the specified command. The green LED turns on when the system is ready to recevie a new command.
8 | Repeat step 6 | DUT should clear buffer of inputs/outputs (E.g. should not repeat the previous command) |  | Sends error message and asks for a nee valid one. Red LED is turn on.
9 | Send the SPARC a command to execute a Touch/Press screen. | DUT able to do Touch/Press screen. |  | SPARC generates a touch perfectly.
10 | Send command to execute movement on X | DUT able to move on X | Reviewer: Take the velocity of movement and compare with the Teams requirement If team requiments specify an acknowledge from commands, verify in terminal that they are sent. | DUT able to move on X
11 | Send command to execute movement on Y | DUT able to move on Y | Reviewer: Take the velocity of movement and compare with the Teams requirement If team requiments specify an acknowledge from commands, verify in terminal that they are sent. | DUT able to move on Y
12 | Execute multiple movements on Y that go beyond the limits of the work area. | DUT able to detect limit on Y and stop operation. |  | The SPARC does not accept commads that go beyond the work area. It sends error message and ask for a new command.There's visual acknowledge(LED).
13 | Execute multiple movements on X that go beyond the limits of the work area. | DUT able to detect limit on X and stop operation. |  | The SPARC does not accept commads that go beyond the work area. It sends error message and ask for a new command.There's visual acknowledge(LED).
14 | Execute a Slide screen command. | DUT able to execute Slide movements | Reviewer: Verify if team under revision has the Slide Screen Command requirement defined. If team requiments specify an acknowledge from commands, verify in terminal that they are sent. | The actuator performs the slide.
# | Action | Expected Result | Notes | Result
Inputs:
Pre-Conditions: | Docklight is used as a serial terminal that allows the tester to freely select any baud rate, stop bits, payload, bit parity and configurations.
Post-Conditions:
Date Created: | 2019-12-08
Date Executed: | 2019-12-10
Tags:
Comments: | A complete test was performed and the behavior of the system was the expected. All LED's worked well, when they must. Emergency stop, turn on off button as well. Excellent performance.

Sheet: SummaryOfTesting
The performance of the system is the desired. Movement is correct and precise. The status update are wel given by the led's. Limits are respected and there is no hardware problem.
