FelipeRojasArr/Curiosity_SPARC/2D drawings/torre para motor.PDF

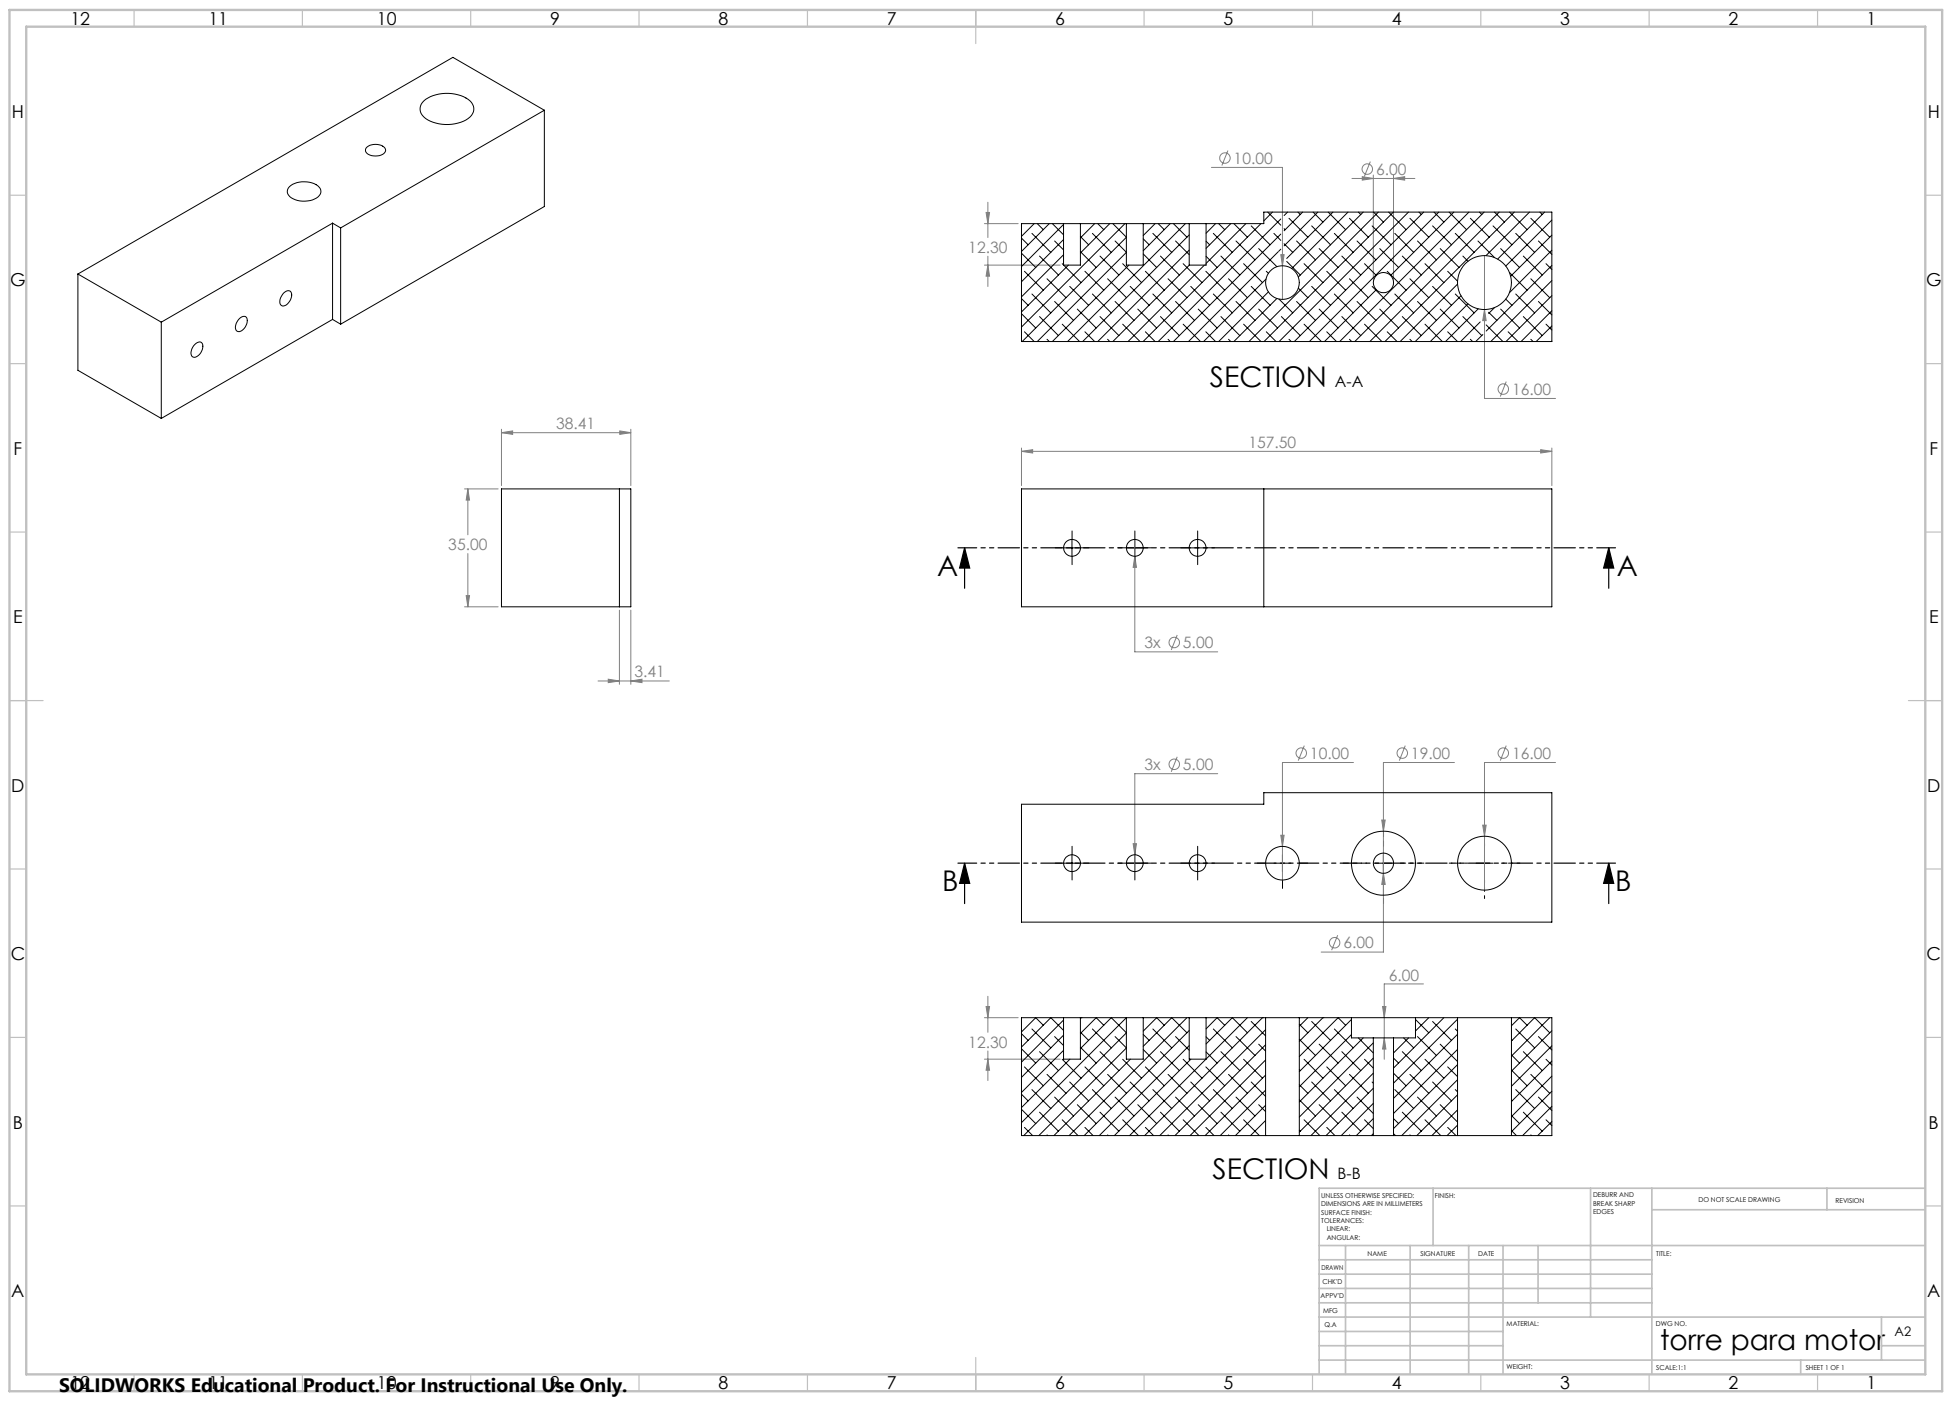
[picture p71: page 1]
SECTION A-A; SECTION B-B; FINISH:; DEBURR AND; BREAK SHARP; DO NOT SCALE DRAWING; REVISION; SCALE:1:1; SHEET 1 OF 1

UNLESS OTHERWISE SPECIFIED:
DIMENSIONS ARE IN MILLIMETERS
SURFACE FINISH:
TOLERANCES:
LINEAR:
ANGULAR:

NAME | SIGNATURE | DATE | | | | TITLE:

DRAWN
CHK'D
APPV'D
MFG
Q.A | | | | MATERIAL: | DWG NO. torre para motor | A2

SOLIDWORKS Educational Product. For Instructional Use Only.
