FelipeRojasArr/Curiosity_SPARC/2D drawings/LeadScrew Nut 8mm x 2mmPitch.PDF

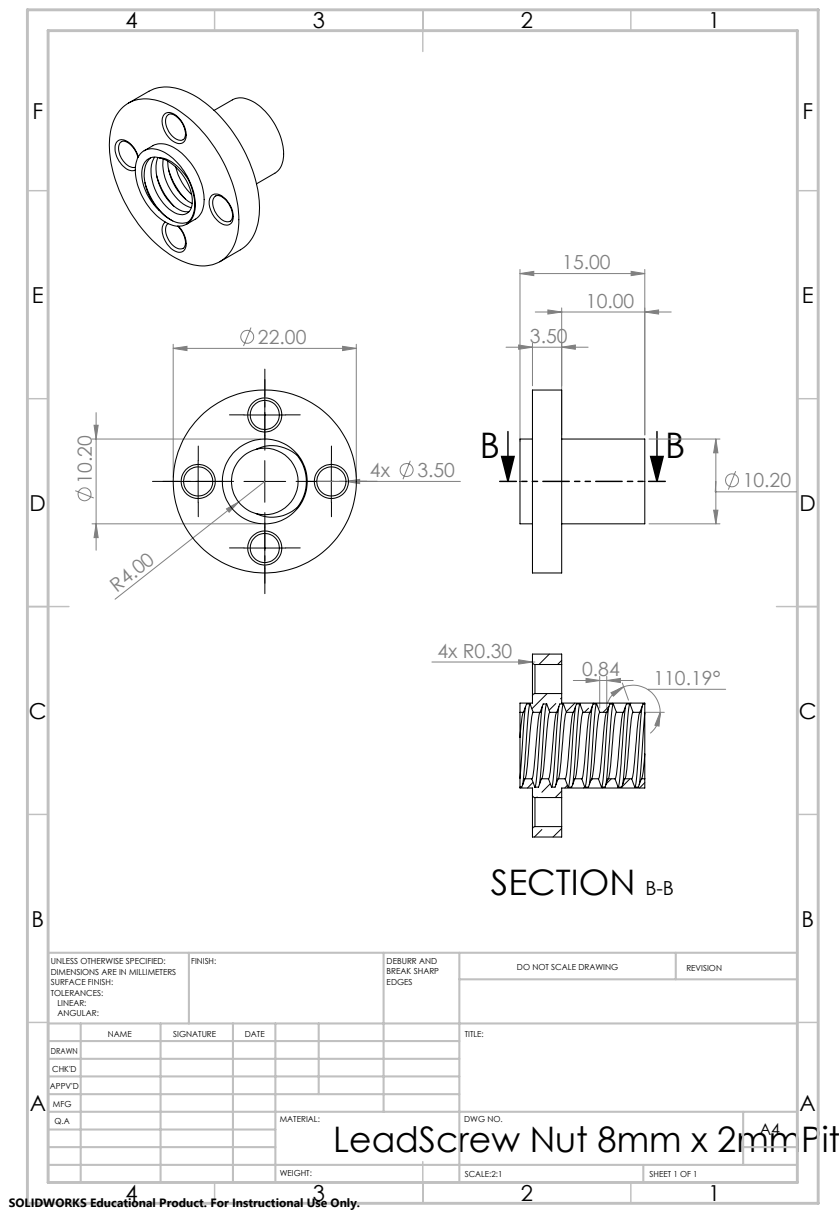
[picture p73: page 1]
SECTION B-B; FINISH:; DEBURR AND; BREAK SHARP; DO NOT SCALE DRAWING; REVISION; SCALE:2:1; SHEET 1 OF 1; LeadScrew Nut 8mm x 2mmPitch

UNLESS OTHERWISE SPECIFIED:
DIMENSIONS ARE IN MILLIMETERS
SURFACE FINISH:
TOLERANCES:
LINEAR:
ANGULAR:

NAME | SIGNATURE | DATE | | | | TITLE:

DRAWN
CHK'D
APPV'D
MFG
Q.A | | | | MATERIAL: | DWG NO. | A4

SOLIDWORKS Educational Product. For Instructional Use Only.
