FelipeRojasArr/Curiosity_SPARC/2D drawings/carrito eje y para tuerca2.PDF

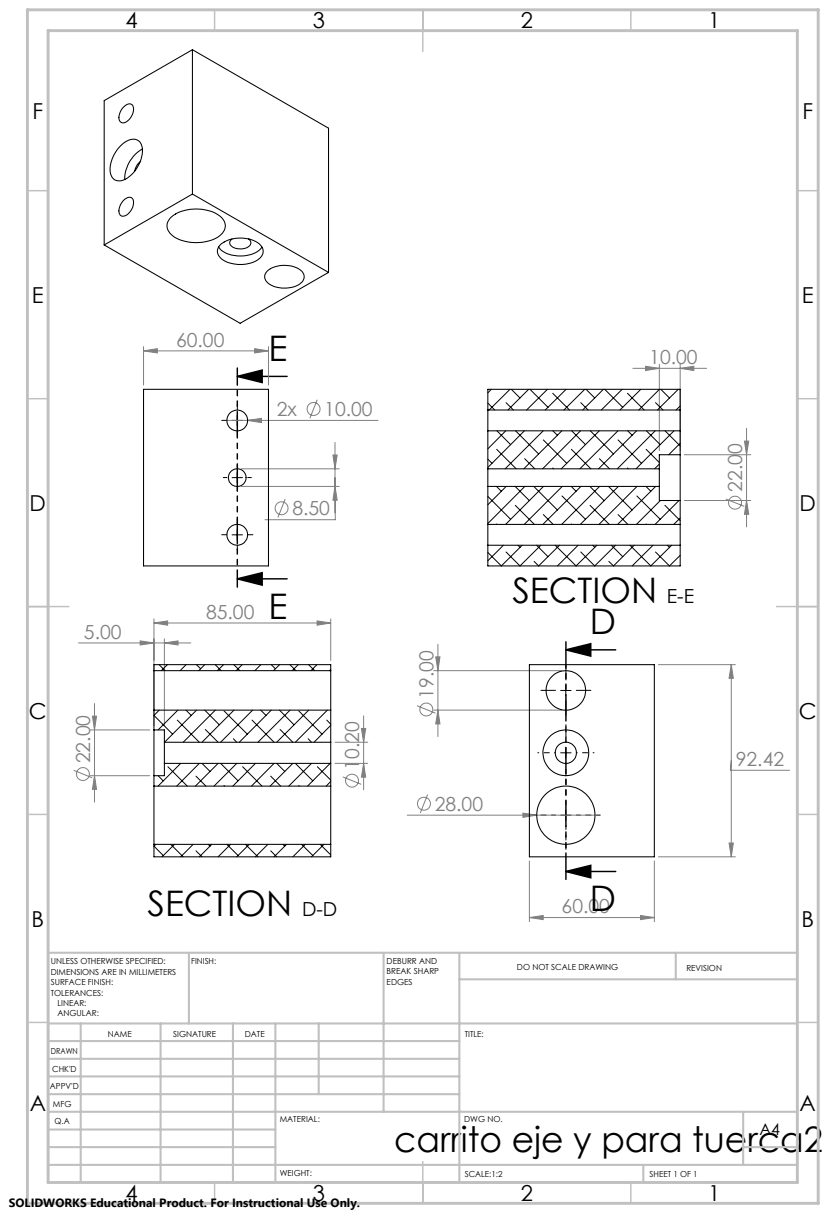
[picture p75: page 1]
SECTION D-D; SECTION E-E; FINISH:; DEBURR AND; BREAK SHARP; DO NOT SCALE DRAWING; REVISION; SCALE:1:2; SHEET 1 OF 1

UNLESS OTHERWISE SPECIFIED:
DIMENSIONS ARE IN MILLIMETERS
SURFACE FINISH:
TOLERANCES:
LINEAR:
ANGULAR:

NAME | SIGNATURE | DATE | | | | TITLE:

DRAWN
CHK'D
APPV'D
MFG
Q.A | | | | MATERIAL: | DWG NO. | A4

carrito eje y para tuerca2

SOLIDWORKS Educational Product. For Instructional Use Only.
