FelipeRojasArr/Curiosity_SPARC/2D drawings/61205K790_FIXED ALIGNMENT LINEAR BALL BRNG.PDF

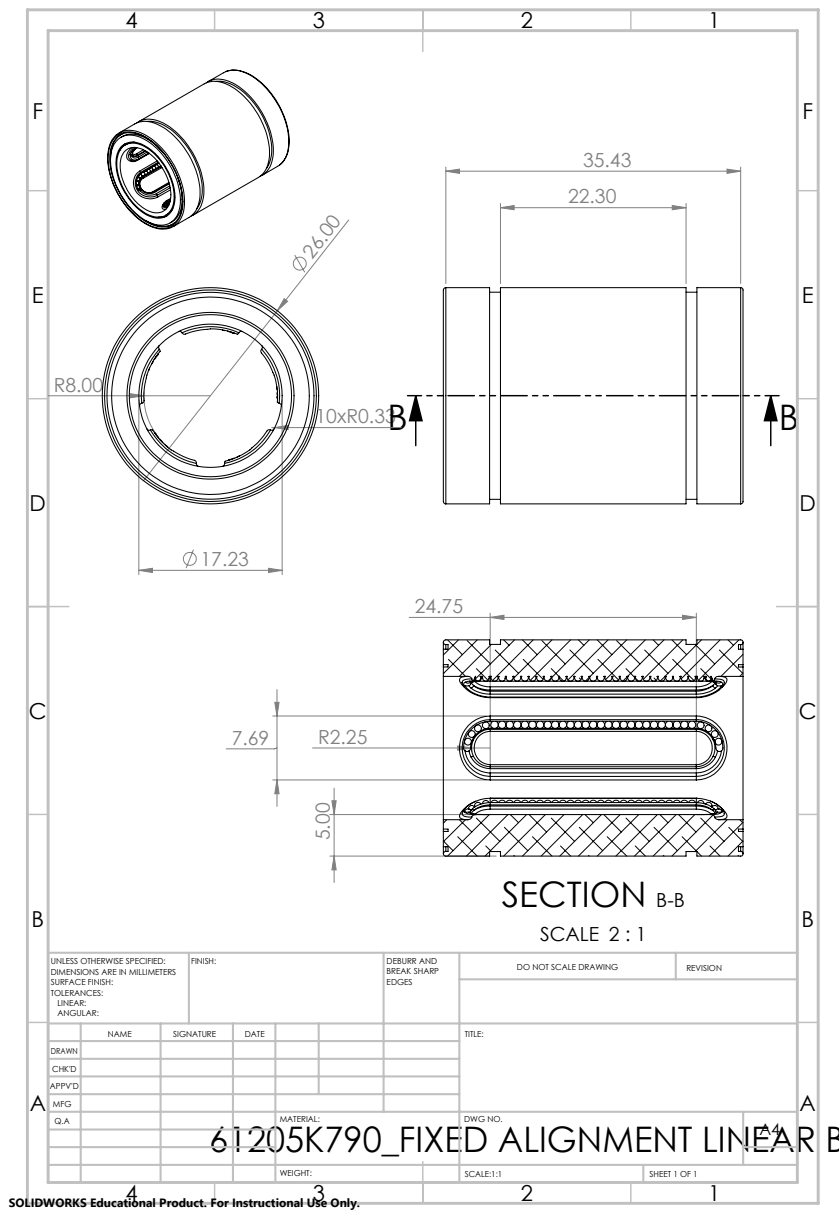
[picture p76: page 1]
SECTION B-B; SCALE 2 : 1; FINISH:; DEBURR AND; BREAK SHARP; DO NOT SCALE DRAWING; REVISION; SCALE:1:1; SHEET 1 OF 1

UNLESS OTHERWISE SPECIFIED:
DIMENSIONS ARE IN MILLIMETERS
SURFACE FINISH:
TOLERANCES:
LINEAR:
ANGULAR:

NAME | SIGNATURE | DATE | | | | TITLE:

DRAWN
CHK'D
APPV'D
MFG
Q.A | | | | MATERIAL: | DWG NO. | A4

61205K790_FIXED ALIGNMENT LINEAR BALL BRNG

SOLIDWORKS Educational Product. For Instructional Use Only.
