FelipeRojasArr/Curiosity_SPARC/2D drawings/6661K110_BALL BEARING.PDF

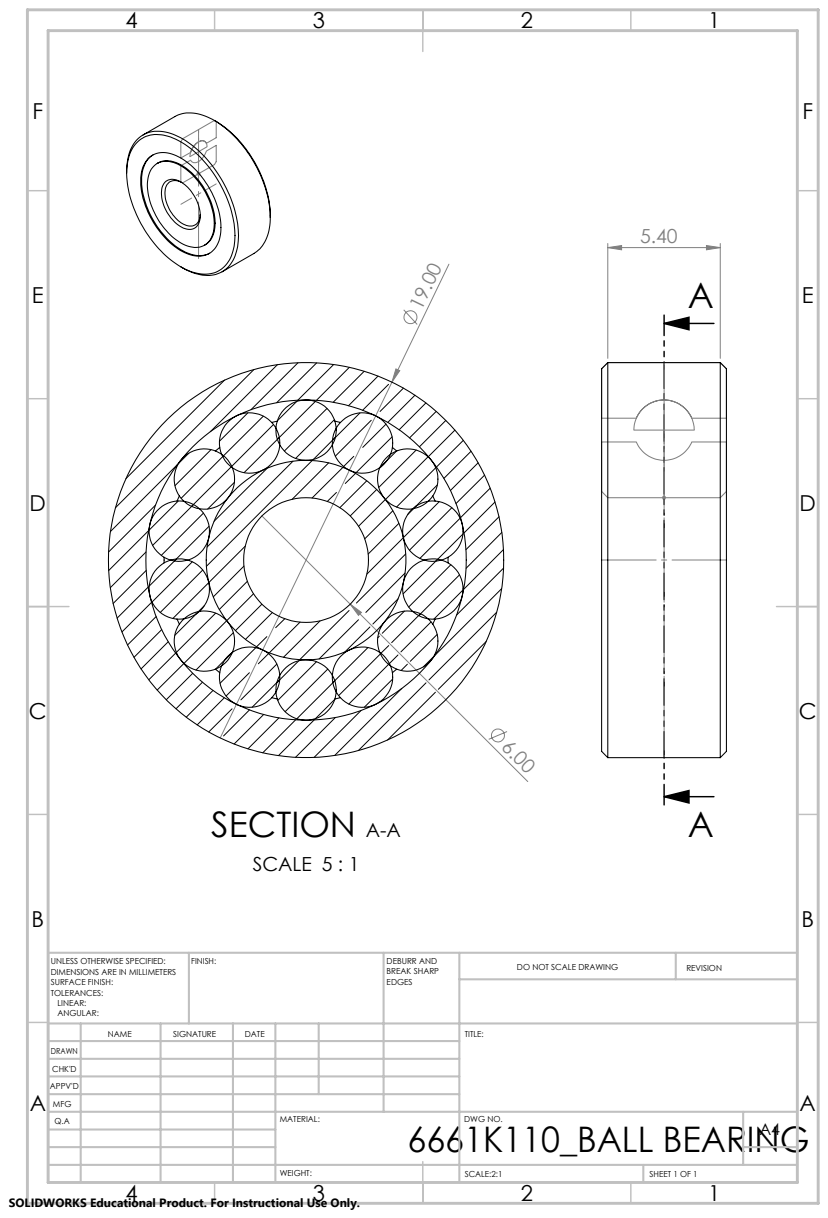
[picture p77: page 1]
SECTION A-A; SCALE 5 : 1; FINISH:; DEBURR AND; BREAK SHARP; DO NOT SCALE DRAWING; REVISION; SCALE:2:1; SHEET 1 OF 1

UNLESS OTHERWISE SPECIFIED:
DIMENSIONS ARE IN MILLIMETERS
SURFACE FINISH:
TOLERANCES:
LINEAR:
ANGULAR:

NAME | SIGNATURE | DATE | | | | TITLE:

DRAWN
CHK'D
APPV'D
MFG
Q.A | | | | MATERIAL: 6661K110_BALL BEARING | DWG NO. | A4

SOLIDWORKS Educational Product. For Instructional Use Only.
