FelipeRojasArr/Curiosity_SPARC/(commit log)

2019-10-04 IronMan_TestCaseFormat
    Primera version del test case format. Se rechazó el requirement under test.
2019-10-04 Sith Knight_TestCaseFormat
    Primera version test case format. Se rechazó el requirement under test.
2019-10-06 cool down temperature to turn on again
2019-10-20 Planos 2D pieza: ball bearing
    [6661K110_BALL BEARING.SLDDRW]
2019-10-20 Piezas Eje en x, balero
    [61205K790_FIXED ALIGNMENT LINEAR BALL BRNG.SLDDRW, carrito eje x.SLDDRW]
2019-10-20 Carrito Eje y
    [carrito eje y para tuerca2.SLDDRW]
2019-10-20 4 piezas (planos)
    [Lateral1.SLDDRW, LeadScrew Nut 8mm x 2mmPitch.SLDDRW, Superior.SLDDRW, soporte frontal.SLDDRW]
2019-10-20 Torre para motores 2d
    [torre para motor.SLDDRW]
2019-10-20 Ejes fuertes y débiles
    [varilla 10 mm 2.SLDDRW, varilla eje y.SLDDRW]
2019-10-21 Test case Status added
2019-10-21 Update Test Case
    Versión actualizada de Test cases
2019-10-22 Default position Servo test case added
2019-11-19 UART configuration
2019-11-19 Create PWM4550-50DC
2019-11-20 PWM .c file added
2019-11-20 PWM.c added to a folder
2019-11-21 PWM 2Motors
    New Osccon=4MHz Calculations with 8MHz
2019-11-21 PWM2Motors Actualization
    New OSCCON=4MHz PR2=7 CCPRXL= 0x04
2019-11-21 Project file added to folder
    [PWM_mode.X.production.obj, PWM_sine.X.production.obj]
2019-11-22 Configuration to EEPROM
    [ConfigurationEEPROM.h]
2019-11-22 Saque de la funcion los valores de x y y
2019-11-22 saque a x y y de la funcion con apuntadores
2019-11-24 coord para MPLAB
2019-11-25 ya no hay errores
    [main.c]
2019-11-25 Timers Interruptions Program
    Programa con 2 timers y sus respectivas interrupciones. Con leds de salida para probar.
2019-11-26 Ahora es con maquina de estados. Solo falta corregir los ultimos 2.
2019-11-26 Pruebas timers
2019-11-26 Maquina de estados funcional
2019-11-26 Proyecto PWM en MPLAB
2019-11-28 Nuevo pryecto de PWM
    Ya mueve motors
2019-11-28 Prueba con LED
2019-11-28 Elimine archivos que no necesitamos
    [PWM_mode.X.production.obj, PWM_sine.X.production.obj]
2019-11-28 Agregue proyecto completo de PWM
2019-11-28 inicial stage of merging all the files
2019-11-28 quite el loop infinito y el main tiene una sola funcion
2019-11-28 PWM File updated
2019-11-29 Interruption configuration added
2019-12-01 Agregue archivo solenoide
2019-12-01 Agregue header de config y archivo de movimiento
2019-12-01 Revert "Agregue header de config y archivo de movimiento"
    This reverts commit c5eec2e614689f76f419a0f56c018449d70bdb21.
    [Solenoide.c]
2019-12-01 Agregue header de config y archivo de movimiento"
2019-12-01 Agregue configuración de puertos y pwm
2019-12-01 Adding Interruption Configuration
2019-12-01 Interruptions configuration for main.c
2019-12-02 Volví a agregar el archivo de configuración
    Se borró el archivo, quién sabe por qué y lo volví a agregar
2019-12-02 Programa completo
    Ya compila y mueve el motor
2019-12-03 Corrección de problemas con coordenadas
    Arreglé problema de coordenadas iniciales y en PWM
    [CONFIGUR.c, Configuracion.h, Interruptions.c, PWM.c, PWM.h, cases.h, main.c]
2019-12-03 Adding interruptions for call instrucctions
2019-12-04 Presentación Final
    Agregué presentación final al folder de documentación.
2019-12-04 Interruptions and instrucctions coordinates OK
    missing revision on Verfication
    [CONFIGUR.c, Movimiento.c, PWM.c, main.c]
2019-12-05 Test Case Evaluation
    Primer test case evaluation solo con serial
    [Test_Case_Evaluation.xlsx]
2019-12-05 Code review: Package of data are not sent correctly
    [coordenadas.c, main.c]
2019-12-06 Restricction read from UART
    Overflow procedure algorithm implemented: OERRS bit and Block lecture
2019-12-06 testing code: failures on interruptions
    [CONFIGUR.c, Definiciones.h, PWM.c, main.c, main.h]
2019-12-10 Testing Go to coordinate
    Interruptions are not activated during this step
2019-12-10 Files organized
    [Semestre_i_DFMEA_Template.xlsx]
2019-12-11 Activity Diagram SPARC
    Diagram of main flow of the SPARC.
2019-12-11 Gantt Diagram
    [GanttCool.xlsx]
2019-12-11 Interruptions removed
    Set point to zero now works as GPIO instead of interruptions
2019-12-11 LED messages
2019-12-11 BOM Cost
    [BOM COSTEADO.xlsx]
2019-12-11 HEX file added. Interruptions removed
2019-12-11 Gantt Update
    [GanttCool.xlsx]
2019-12-11 Test Case Update
    [Test_Case_Evaluation.xlsx]
2019-12-11 Removed EEPROM and Interruptions files
    [ConfigurationEEPROM.h]
2019-12-12 Archivo de Manual de ensamblaje agregado
2020-01-12 Adding EEPROM and Conf files
    [ConfigurationEEPROM.h]
2020-01-12 Interruptions file changes
